hransom528/6502/README.md

<h1 align="center">6502</h1>
<p>
  <a href="https://github.com/hransom528/6502/blob/master/LICENSE" target="_blank">
    
  </a>
</p>

<h2>Source code, schematics, documentation, and pictures of my Ben Eater-inspired 65c02 build</h2>

VASM 6502 Oldstyle code

Be sure to check out [Ben Eater!](https://eater.net/)

Figure 1
05/2023 Schematic:
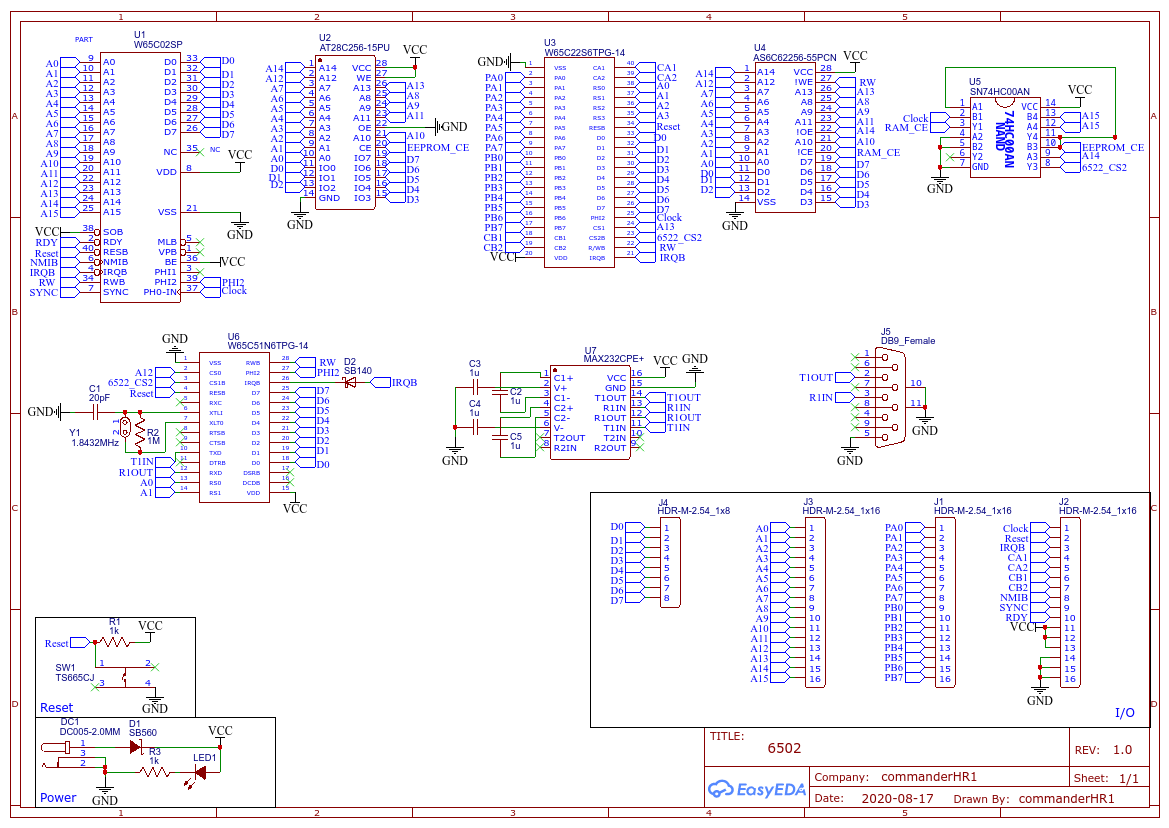
[picture p1: photos/6502_Schematic_05_19.png]
6502 Schematic


Figure 2
05/2023 PCB Layout:
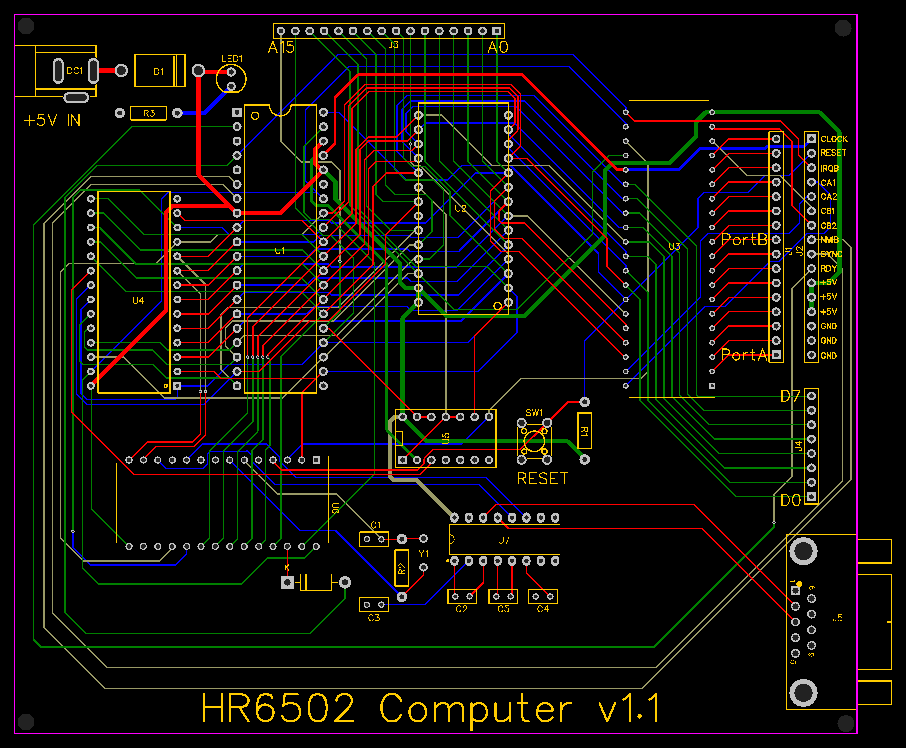
[picture p2: photos/6502_PCB_05_19.png]
6502 PCB


Copyright © 2023 [Harris Ransom](https://github.com/hransom528).<br />
This project is [MIT](https://github.com/hransom528/6502/blob/master/LICENSE) licensed.
