hransom528/6502/photos/AddingRAM.jpg

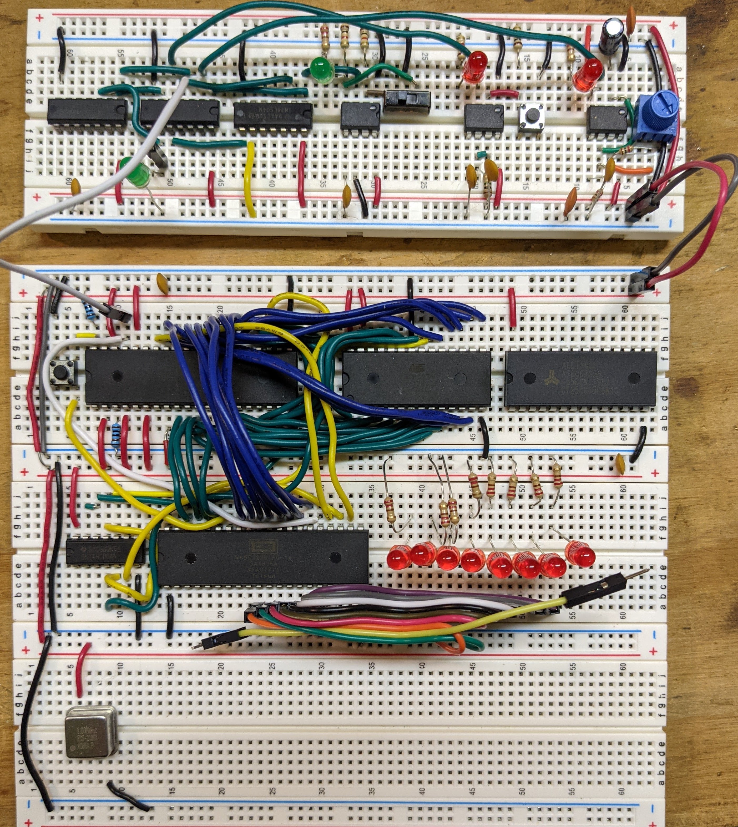
photos/AddingRAM.jpg
