hransom528/6502/photos/Day2.jpg

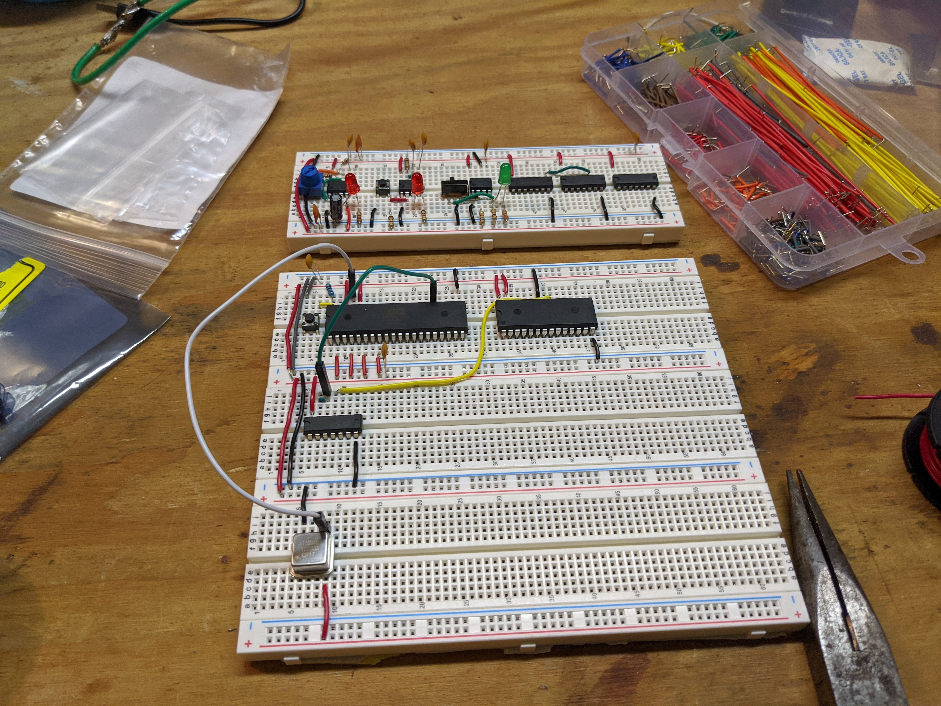
photos/Day2.jpg
