hransom528/6502/photos/RotateLightsRunning.jpg

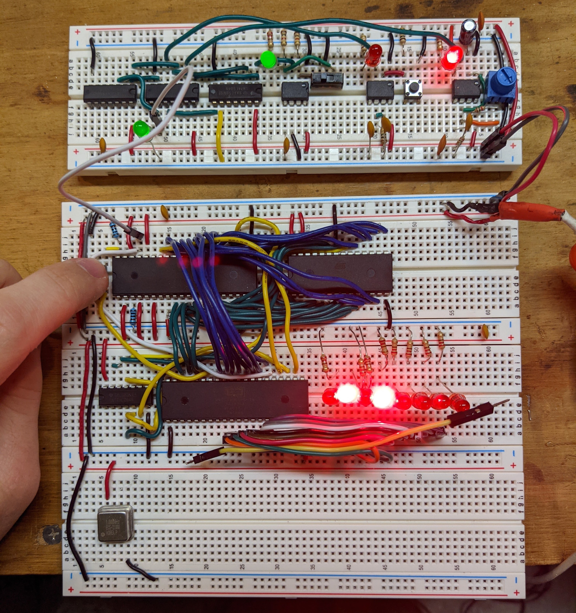
photos/RotateLightsRunning.jpg
