hransom528/6502/6502_BOM.ods

6502 COMPUTER
Mouser # | Mfr. # | Manufacturer | Customer # | Description | RoHS | Lifecycle | Order Qty. | Price (USD) | Ext.: (USD)
595-SN74LS04N | SN74LS04N | Texas Instruments |  | Inverters Hex Inv w/HV Output | RoHS Compliant |  | 1 | $0.73 | $0.73
926-LM555CN/NOPB | LM555CN/NOPB | Texas Instruments |  | Timers & Support Products TIMER | RoHS Compliant |  | 3 | $1.14 | $3.42
595-SN74LS08N | SN74LS08N | Texas Instruments |  | Logic Gates Quad 2-Input. | RoHS Compliant |  | 1 | $0.66 | $0.66
595-SN74LS32N | SN74LS32N | Texas Instruments |  | Logic Gates Quad 2-Input | RoHS Compliant |  | 1 | $0.61 | $0.61
955-W65C02S6TPG-14 | W65C02S6TPG-14 | Western Design Center (WDC) |  | Microprocessors - MPU 8-bit Microprocessor | RoHS Compliant |  | 1 | $6.95 | $6.95
955-W65C22S6TPG-14 | W65C22S6TPG-14 | Western Design Center (WDC) |  | I/O Controller Interface IC Versatile Interface Adapter | RoHS Compliant |  | 1 | $6.95 | $6.95
556-AT28C25615PU | AT28C256-15PU | Microchip |  | EEPROM 256K 32K x 8 150 ns 4.5V-5.5V | RoHS Compliant |  | 1 | $8.88 | $8.88
913-AS6C62256-55PCN | AS6C62256-55PCN | Alliance Memory |  | SRAM 256K, 2.7-5.5V, 55ns 32K x 8 Asynch SRAM | RoHS Compliant |  | 1 | $2.54 | $2.54
595-SN74HC00AN | SN74HC00AN | Texas Instruments |  | Logic Gates | RoHS Compliant | New Product | 1 | $0.48 | $0.48
520-TCH100-X | ECS-2100AX-1.0MHZ | ECS |  | Standard Clock Oscillators DIP-8 5V 1MHz | RoHS Compliant |  | 1 | $2.50 | $2.50
858-P160KN0QD15B1M | P160KN-0QD15B1MEG | TT Electronics |  | Potentiometers 16mm 1M ohm | RoHS Compliant |  | 1 | $0.76 | $0.76
603-CFR-25JT-52-1M | CFR-25JT-52-1M | Yageo |  | Carbon Film Resistors - Through Hole 1/4W 1M Ohm 1% | RoHS Compliant |  | 5 | $0.10 | $0.50
603-CFR-12JT-52-1K | CFR-12JT-52-1K | Yageo |  | Carbon Film Resistors - Through Hole 1Kohm 5% 1/6W Carbon Film | RoHS Compliant |  | 20 | $0.055 | $1.10
603-CFR-25JT-52-220R | CFR-25JT-52-220R | Yageo |  | Carbon Film Resistors - Through Hole 220ohm 5% 1/4W Carbon Film | RoHS Compliant |  | 15 | $0.046 | $0.69
791-YV101103Z60HAND5 | YV101103Z060HAND5P | Walsin |  | Multilayer Ceramic Capacitors MLCC - Leaded CAP Y5V 10 nF -20~+80% 100V 5LS T&A | RoHS Compliant | New At Mouser | 10 | $0.10 | $1.00
763-0216K1Z-FSW-FBW | NHD-0216K1Z-FSW-FBW-L | Newhaven Display |  | LCD Character Display Modules & Accessories FSTN (+) Transfl 80.0 x 36.0 | RoHS Compliant |  | 1 | $8.47 | $8.47
854-BB830 | BB830 | BusBoard Prototype Systems |  | PCBs & Breadboards 830 TIE POINT PLUG IN BRDBOARD | RoHS Compliant |  | 4 | $8.80 | $35.20
611-PTS645SM50SMTR92 | PTS645SM50SMTR92LFS | C&K Switches |  | Tactile Switches 6 mm Tact Switches | RoHS Compliant |  | 9 | $0.25 | $2.25
710-151051SS04000 | 151051SS04000 | Wurth Elektronik |  | Standard LEDs - Through Hole WL-TMRC THT Mono Diffused Rnd5mm Red | RoHS Compliant |  | 10 | $0.23 | $2.30
858-P160KNP0QC15A1K | P160KNP-0QC15A1K | TT Electronics |  | Potentiometers 1/10W 1K Ohms 20% 16mm ROTARY POT | RoHS Compliant |  | 1 | $0.95 | $0.95
604-WP57YYD | WP57YYD | Kingbright |  | Standard LEDs - Through Hole BI-POLAR YELLOW DIFF | RoHS Compliant |  | 10 | $0.27 | $2.70
828-OVLFB3C7 | OVLFB3C7 | TT Electronics |  | Standard LEDs - Through Hole Blue 470 nm | RoHS Compliant |  | 5 | $0.34 | $1.70
123-09.10290.01 | 09.10290.01 | EAO |  | Slide Switches 1K2 BLK ACT GOLD RIGHT ANGL MNT | RoHS Compliant |  | 1 | $1.43 | $1.43
81-RDER71H105K2K1H3B | RDER71H105K2K1H03B | Murata |  | Multilayer Ceramic Capacitors MLCC - Leaded 1.0UF 50V 10% 5.0MM | RoHS Compliant |  | 5 | $0.58 | $2.90
810-FG28X5R1E106MR06 | FG28X5R1E106MRT06 | TDK |  | Multilayer Ceramic Capacitors MLCC - Leaded RAD 25V 10uF X5R 20% LS:5mm | RoHS Compliant |  | 5 | $0.50 | $2.50
485-3314 | 3314 | Adafruit |  | Adafruit Accessories 1/2 Breadbrd + 78 pc 22AWG Jumper Wire | RoHS Compliant |  | 1 | $9.95 | $9.95
Total:
$108.12
