hransom528/6502/schematics/PCB_PCB_6502 Computer_2023-03-06.pdf

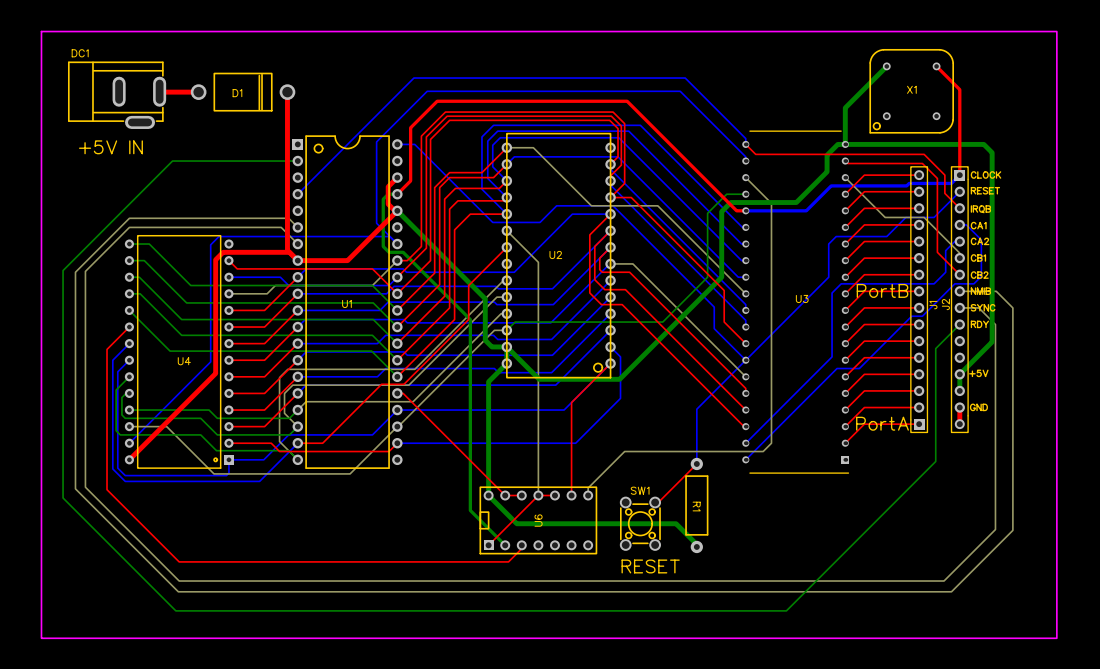
[picture p6: page 1]
