hransom528/6502/schematics/Schematic_6502 Computer_2023-03-06.pdf

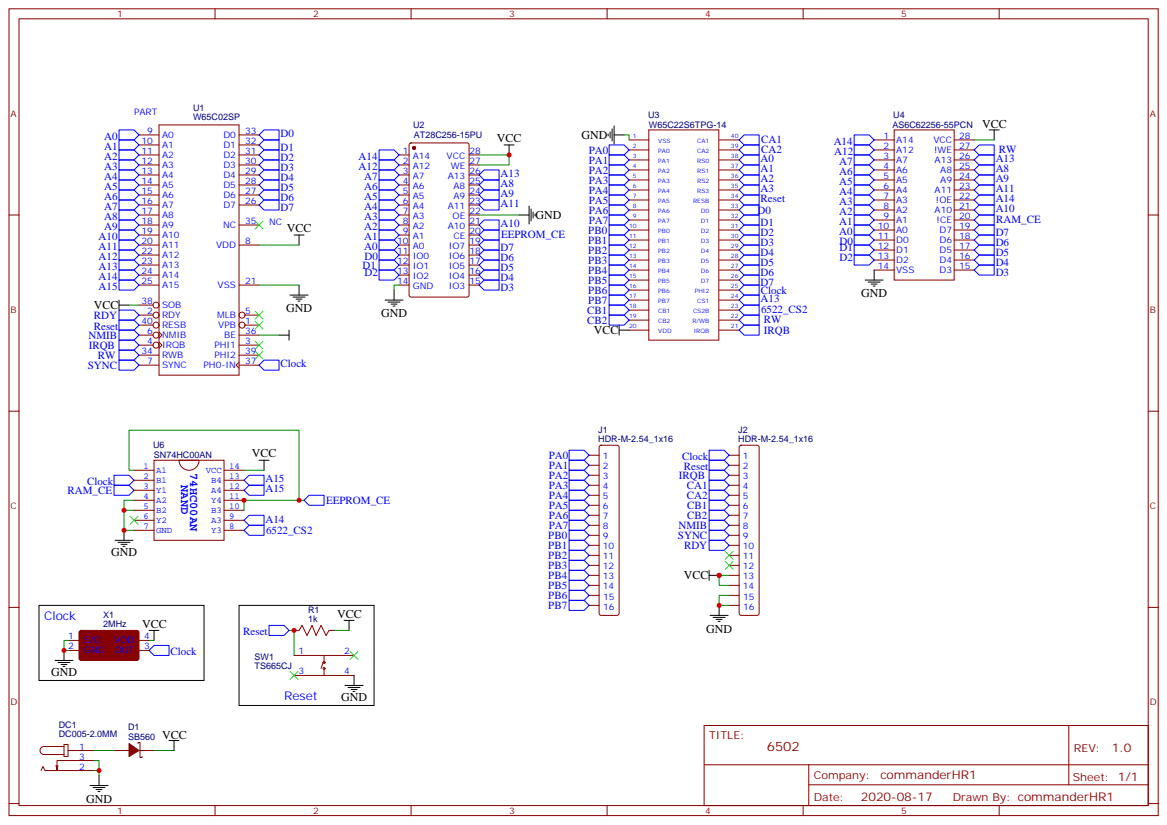
[picture p7: page 1]
