hransom528/6502/schematics/6502_Schematic_2020-08-22_21-45-33.pdf

## Noise Reduction

## Astable

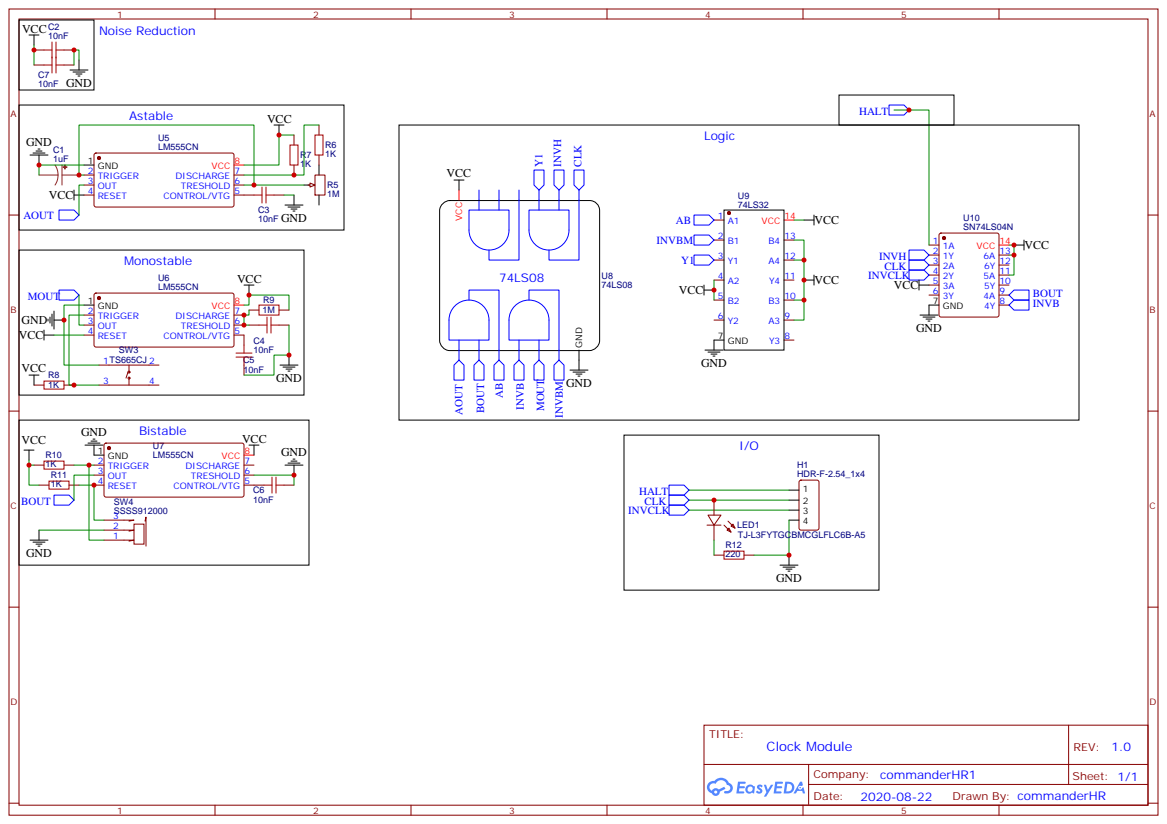
[picture p8: page 1]

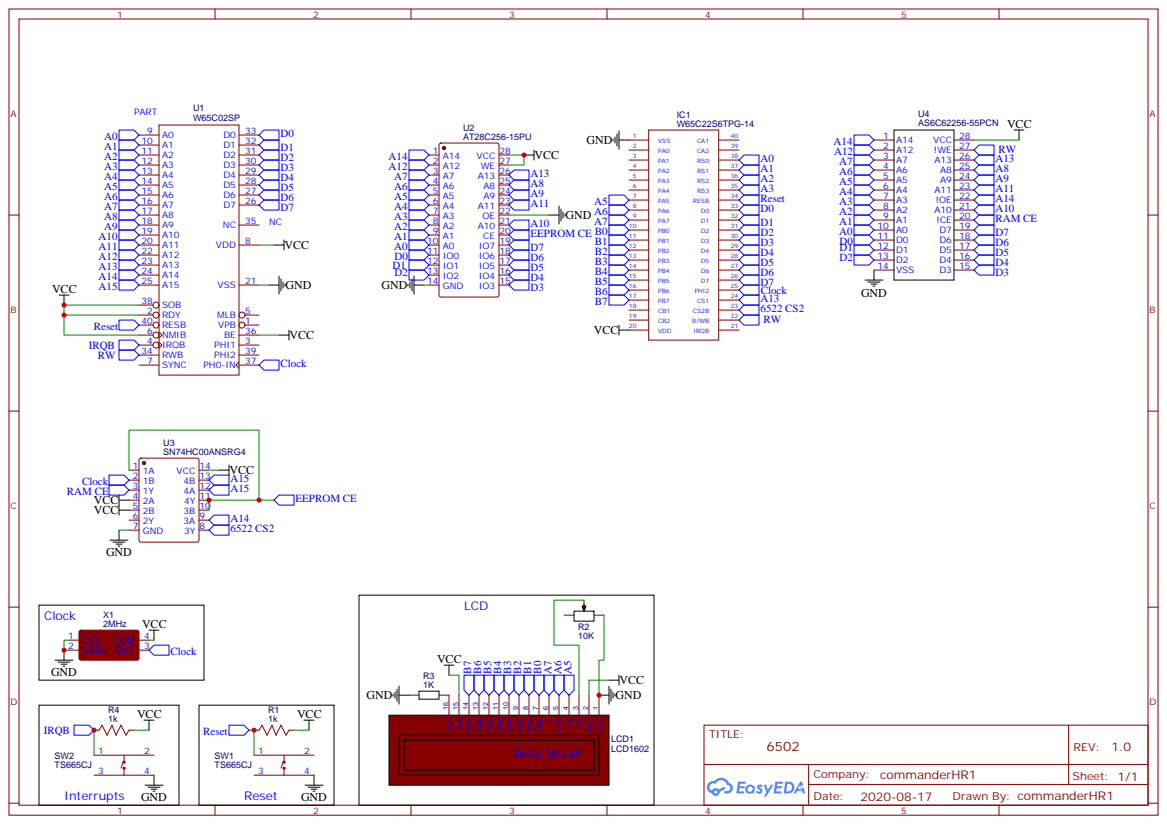
[picture p9: page 2]
