hransom528/6502/schematics/6502_Schematic_2020-08-18_19-48-06.pdf

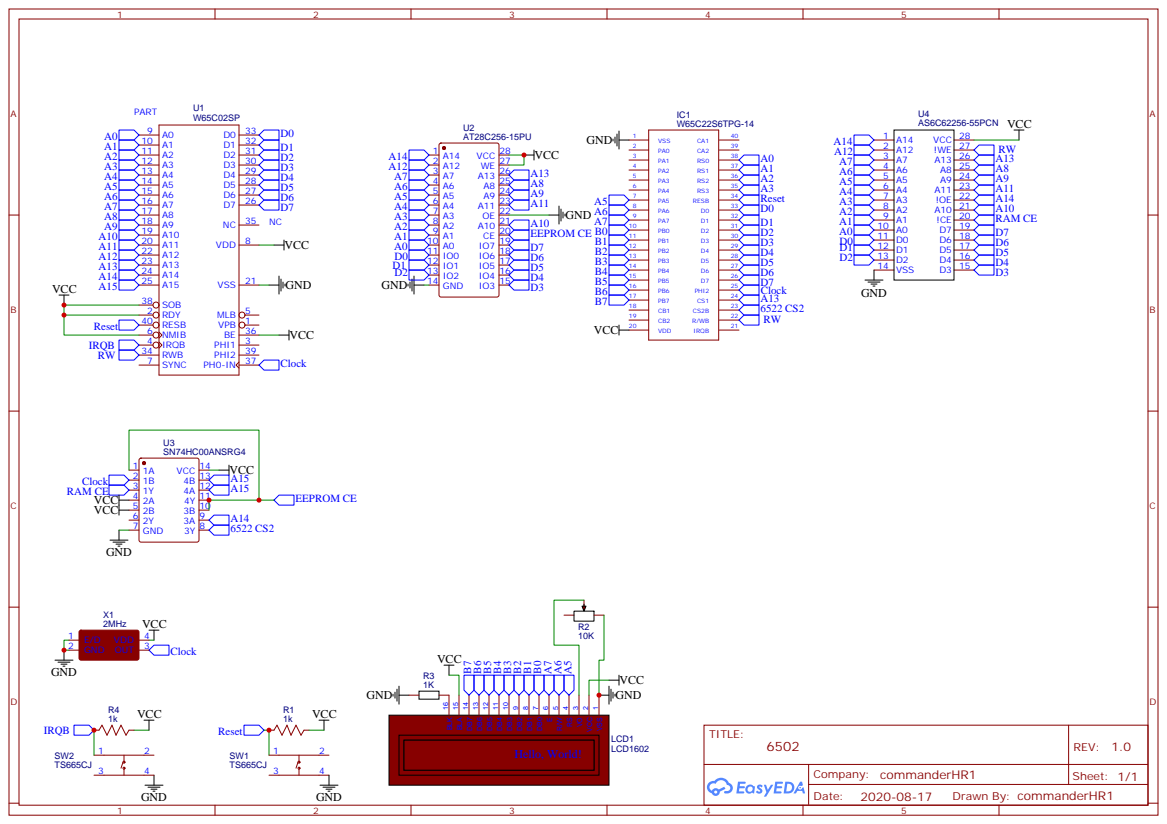
[picture p10: page 1]
