hransom528/6502/(commit log)

2020-08-17 Added BOM spreadsheet
    [6502_BOM.ods]
2020-08-17 Updated BOM
    [6502_BOM.ods]
2020-08-18 Added starter assembly code
2020-08-18 Added interrupt code, updated makefile and other code
2020-08-18 Added schematics, updated TODO
2020-08-23 Added new schematic, added schematic folder
