hransom528/6502/(notices)

Notices in the files:
README.md:
License: MIT
